gi1mic/rc28_emulator/(threads)

Thread 1 (2021-07-13):

Not recognized by IC7610

m0vse, 2021-07-13:
Hi.

I have been testing your RC-28 emulator and it works well on RS-BA1 but if I plug it into the front of my IC-7610, it doesn't appear to be recognized. Is there anything that I can try? Obviously it is difficult as there is no way to get any debugging information!

73 Phil M0VSE

gi1mic, 2021-07-14:
I had wondered about 7610 compatability.

The emulator presents itself slightly differently to the usb host machine
than an actual rc-28.

The rc28 appears as a single device while the emulator also appears as a
serial and hid keyboard device.

The rc28 also uses usb "interrupt" messages.

The tricky bit is figuring out what the 7610 actually requires.  There are
a number of limitations imposed by the arduino usb libraries which mean you
can't be 100% compatible with the pic microchip as used in the rc28

I would have to refresh my memory on the code as I have been off working on
other things recently. But it may be possible to create a simple test
script to try and determine what the 7610 requires.

Gareth

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

m1geo, 2022-11-05:
Also interested in this. If I can be of any help, let me know debugging. George, M1GEO.

ON7EQ, 2022-12-19:
Hello all

Same issue here with IC-7610. I have changed the sketch to disable the USB serial port (CDC), but monitor (for debugging) the data on Serial1  (the second port on the Leonardo). With WFview software and the ICOM provided I/Q driver the emulated RC-28 is recognized and working, Driver starts by requesting the version, then constantly polls data '3'.  When the Leonardo is inserted in IC-7610, apparently the rig doesn't send any data whatsoever .... It would be nice to be able to trace data on the USB line with a sniffer, but this piece of hardware will probably cost more than RC-28, so makes no sense .... Anyhow, a nice project and challenge - thanks GAreth for sharing ! 73 de ON7EQ Jean-Jacques

Thread 2 (2023-03-31):

My Emulator isn't recognized by RS-BA1 v 1.96

wa7mxz, 2023-03-31:
I have an Arduino Leonardo running the RC28 sketch with all of the Arduino files updated on my RS-BA! version  1.96 Icom remote software.
The RS-BA1 does not recognize the Arduino so it does not list any RC28 in the pull down menu.
Are there debugging steps I can take to see why it isn't recognized?
The encoder and switches are operating but aren't seen the RS-BA1.

Bob Wood, WA7MXZ

Closed 2023-04-08.
