gi1mic/rc28_emulator/(commit log)

2021-04-25 Update rc28_emulator.ino
    Improved encoder motion (now actually using encoder interrupts and added speed multiply)
2021-04-25 Update rc28_emulator.ino
    Added encoder sensitivity #define
2021-04-25 Update readme.md
    encoder sensitivity updates
